km190112/RS232cToUSBhid/開発memo.pptx

１．開発背景
２液性の接着剤を配合する際、秤で主剤と硬化剤の重量をはかり、配合比が許容誤差内となっているかエクセルVBAツールに手入力で入力し、計算し、合否判定している。（配合量は接着記録にも入力している）
入力はキーボード入力のため、誤入力の懸念や手入力の手間があった。以前はPCにRS232c端子を備えていたが、近年では搭載されずUSBで代用されるようになったため変換器やそれらのドライバの用意が必要となりインターフェースの構築のハードルが高くデータ活用がしづらい場合があった。
そこで、重量計で読み取り出力した値をPCに送るためのデバイスを開発、制作し、手入力レス化を実現した。
市場にはRS232cをBluetooth　HIDプロファイルで送信する機器が販売されているが、Bluetoothを搭載していないPCで利用するため利用条件に合っていなかった。また受け取った信号から数値のみを切り出して出力する機器は市販で販売されていない。
本資料では機器作成に必要な、変換デバイスの仕様と開発に必要なH/Wや通信の知識をまとめた。

２．H/Wの構成のイメージと変換デバイスの仕様

変換デバイスに必要な要件・仕様
機械：Dsub9pin端子をUSB Type-A端子に変換
電気：RS232cの電圧レベルをUSBの電圧レベルに変換
データ処理：重量計から出力する重量値のみを出力(フィルター機能)
通信：プロトコルをRS232c→USB　HIDクラス(キーボード)変換

データはAandD標準フォーマットの値部分のみPCに送信する。
例：AandD標準フォーマット：ST,+00012.78 gCrLf　→　PCへの入力：12.78CrLf
※CrLfは改行コード(Cr：キャリッジリターン、Lf：ラインフィード)

信号の流れ

Dsub9ピン　オス

秤出力データ
ST,+00012.78 g

秤の送信ボタンを押すと
重量データをASCII出力

秤　AandD

USB Type-A端子

PC入力データ
12.78

アプリに自動で
キーボード入力

Windows PC

値部分のみを出力

## Slide 2

３．準備する機器
●重量計はAandD社のFx-iシリーズの秤(AandD標準フォーマット出力に対応していれば他機種でもOK)
●PCはWindows OS　※Mac(unix)は改行コードが合わないため利用不可。
４．仕様
●データはAandD標準フォーマットの値部分のみPCに送信する。
例：AandD標準フォーマット：ST,+00012.78 gCrLf　→　PCへの入力：12.78CrLf
※CrLfは改行コード(Cr：キャリッジリターン、Lf：ラインフィード)
５．変換デバイスの部品リスト

L/N | メーカー | 品名 | 型式 | 参考金額 | 備考
1 | NulSom Inc. 購入はAmazon | RS232c to TTLレベル変換モジュール | NS-RS232 | 2,500 | メーカーが違ってもOK。 開発時に購入したメーカを記載
2 | Seeed Studio 購入はスイッチサイエンスまたは秋月電子通商 | Seeeduino XINO | ー | 850
3 | 機器を入れるケース | | ー | ー
4 | どこでもOK | 電線 | AWG26～28程度 200㎜程度 | ー
5 | ダイソー | グルーガン 透明 | ー | ー

## Slide 3

６.H/Wの接続とブロックごとの機能

RS232cケーブルで配線
9pin ストレート　メスーメス

USBケーブルで配線
TypeA to C

USB
Type-A

TX

RX

GND

秤
AandD　Fz-iシリーズ

Dsubの3番ピンの接続はするが、PCとの接続にHIDのため使用しない。
(ノイズによる誤作動防止)
受信のみなので2と5番ピンのみ利用。

Dsub
9pinオス

②

③

⑤

Dsub
9pinオス

②

③

⑤

開発範囲

3.3v

RX

RX

TX

TX

GND

GND

AWG26ケーブルで配線

3.3v

RX

TX

GND

マイコン
Seeeduino XINO

5v

USB
Type-C

デバイスマネージャーからはHIDキーボードとして認識する。
プラグ アンド プレイ

Windows PC

※WindowsでUSB、HIDクラスについての説明はライブラリでの通信のため省略。

②秤とマイコンの通信設定はボーレート：9600bps
データビット：8、パリティ：なし、停止ビット：1(8n1)
③ PCにUSB　HIDクラスとして認識させる。
④マイコンで信号を一旦保持し、受信が完了したら、
重量の数値部分のみを切り出して。USBでPCに送信。

D+

D-

RS232c通信

RS232c　to TTLレベル変換モジュール
NS-TRS232-02

UART通信
次ページで説明

GND

通信
USB HIDクラス
(キーボード)

①レベル変換モジュールで電圧レベルをRS232cレベルからTTLレベルに変換。

+15V

RS232出力電圧の規格

TTLレベル出力電圧の規格

+5V

0V

“0”

2.4V以上：”1”

+3.3v マイコンの電源電圧

-5V

-15V

“1”

0.4V以下：”0”

## Slide 4

7.予備知識1(UART)
(1).UARTとは（Universal Asynchronous Receiver Transmitter）読み方：ユーアート
●シリアル信号とパラレル信号の変換する集積回路,または通信プロトコル。
※1シリアル通信とは信号をひとつづつ直列にして送り込む。
●２本のワイヤを使用し、非同期式（調歩同期方式）のシリアル通信に対応する。接続は1対1。
●ボーレート(通信速度)は2400bps～1.5Mbps
●正しく処理をするために送信側と受信側のボーレートをあらかじめ合わせておく必要がある。
●パラレル通信と比較し、必要な回路やワイヤの規模、数が抑えられ実装コストも低減できるメリットがある。
(2).UARTのインターフェース
シリアル通信では１本の信号ラインまたはワイヤを使用し、送信用：Tx(トランスミッタ)と、受信用：Rx(レシーバー)の2本の信号線で接続する。
接続は1対1で行われ、各１本(計２本)のワイヤを使用する。※TxはTxD、RxはRxDと表現することもある。

RX

TX

UART1

相互に直接通信を行う２つのUARTデバイス

RX

TX

UART2

データバスへパラレル形式で渡す。
後に説明するデータフレームを受け渡す

データバスへパラレル形式で渡す。
後に説明するデータフレームを受け渡す。

パケットとして送受信

※データバスの通信とLSBについては省略

## Slide 5

(3)UARTのデータ転送
●UARTでは、パケット方式でデータの伝送が行われる。
●送信機器と受信機器の間では、シリアル・パケットの構成や、物理的なハードウェア・ラインの制御といった処理を行う必要がある。
●パケットは、開始ビット、データ・フレーム、パリティ・ビット、停止ビットで構成される。
※フレーム・プロトコルについては説明を省略。

UARTパケットの例

データフレーム
(5～9 Data Bits)

“データ・フレームには、転送の対象となる本来のデータが含まれる。パリティ・ビットを使用する場合、データ・フレームの長さは5～8ビット。パリティ・ビットを使用しない場合には9ビットまで拡張できる。ほとんどの場合、データは最下位ビットから順に送信される（LSB）”

開始ビット
(1bit)

パリティビット
(0～1 bit)

“受信側のUARTデバイスが、伝送中にデータが変化していない（エラーが発生していない）ことを確認する。”

停止ビット
(1～2 bit)

“パケットの終わりを知らせるためのビット。
1～2ビット分の間、データ伝送ラインの電圧をローからハイに引き上げる。”

“通常、UARTのデータ伝送ラインは、データを伝送していないときには電圧レベルがハイの状態で維持。データ転送開始時は、送信側のUARTデバイスは伝送ラインの電圧を1クロック・サイクルの間、ハイからローに引き下げる。
一方、受信側のUARTデバイスは電圧がハイからローに遷移したことを検出すると、ボー・レートの周波数でデータ・フレームのビットの読み出しを開始する。”

引用
AnalogDialogue DEC2020 VOL54 UART――多様な非同期通信に対応可能なハードウェア通信プロトコル
著者：Eric Peňa , Mary Grace Legaspi
https://www.analog.com/jp/analog-dialogue/articles/uart-a-hardware-communication-protocol.html

## Slide 6

８.A&D標準フォーマットと秤設定について取り扱い説明書抜粋

マイコンで受信するデータフォーマットについてA＆Dの取り扱い説明書から抜粋。

秤の設定以下赤枠に設定する。

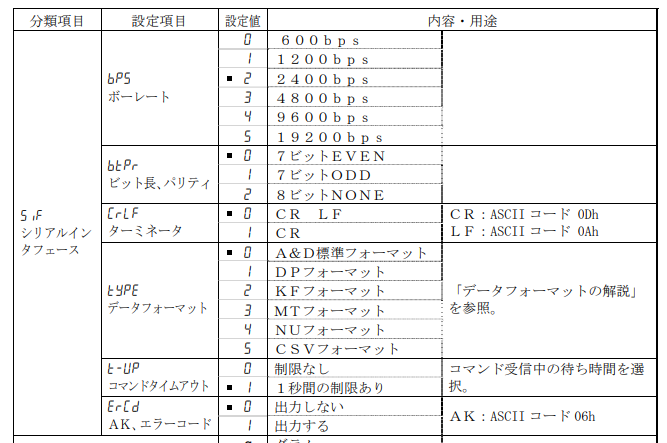
[picture p1: figure]

ボーレート　　　　　：9600bps
ビット長、パリティ　：8bit　None
ターミネータ　　　　：Cr Lf
データフォーマット　：A&D標準フォーマット
コマンドタイムアウト：1秒間の制限あり
エラーコード　　　　：出力しない

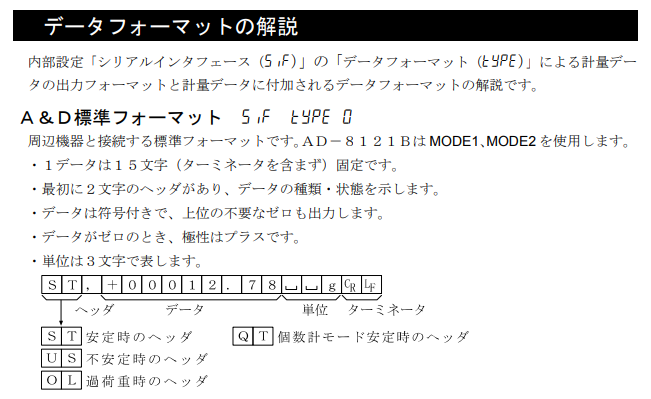
[picture p2: figure]

画像の出典
上皿電子天びん FZ-i/FX-iシリーズ 取扱説明書 - A&D
https://www.aandd.co.jp/pdf_storage/manual/balance/m_fx-i_fz-i.pdf

## Slide 7

８.マイコン(Seeeduino XINO)とは
● 256KB Flashと2KB SRAMを搭載したARM Cortex-M0+ 32bit 48MHz マイクロコントローラー。
●サイズは20x17.5mmで小型。
●Arduino IDEでの開発が可能で高い互換性がある。
※ Arduino IDEとはArduinoボード上で動作するソフトウェアを開発するために作られた統合開発環境。
多くの3rd パーティー製のマイコンボードベンダーがボードパッケージやI/Oライブラリを提供し、開発環境をArduino IDEに統一することで、異なるボード間での移植性が高まったり、Arduino環境向けに開発された各種センサーやI/O制御ライブラリがそのまま利用できるなど多くのメリットがある。

Seeeduino XINOとピン配列

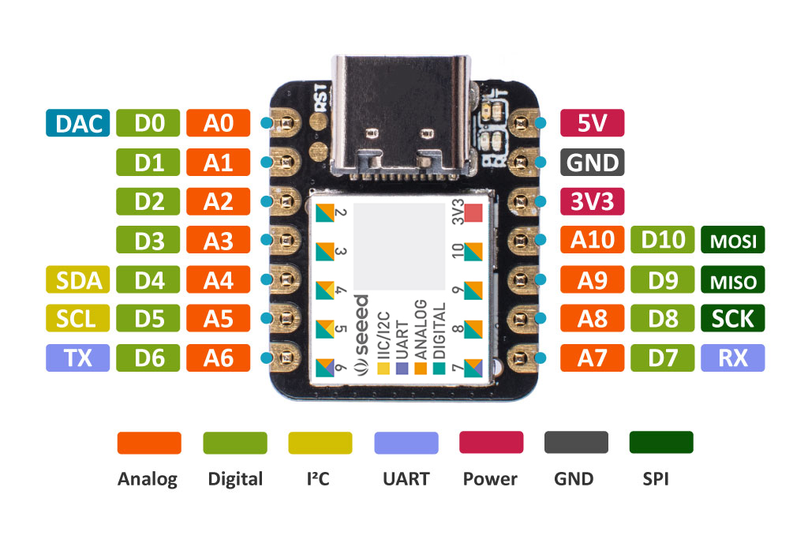
[picture p3: figure]

出典
Seeeduino Xiaoをはじめよう
https://wiki.seeedstudio.com/jp/Seeeduino-XIAO/

ハードウェアシリアル(UART)は2つ用意されており、
UART1はUSBのシリアルチップに接続され
UART2はD6,D7に接続することで利用可能。

統合開発環境Arduino IDE2.0.0の画面

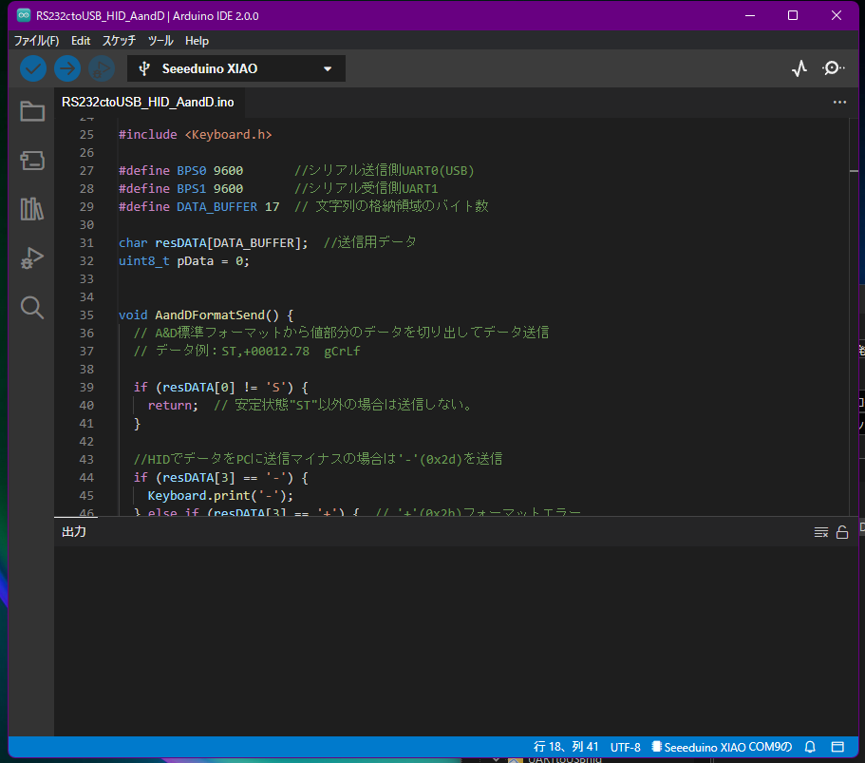
[picture p4: figure]

開発言語はC++に近い
拡張子は.ino

※Arduino IDEのダウンロードと環境構築についての
説明は公式サイトを参照。
https://wiki.seeedstudio.com/jp/Seeeduino-XIAO/
